k3oni/FOC-75300/production/README.md

# Assembly Guide



Wauw, it looks cool, but unfortunately something has gone wrong in this assembly.

What we want to build here will look something like this:



> (This is an image of an old version) The 3d printed enclosure you can find in the /production folder as obj files. You don't necessarily need an enclosure, but it will protect the components from short circuits etc.

For a complete assembly of Free Drive you will need:



Pcs | Part | LCSC order no.
| ----- | ----- | ----- |
1 | Pre-assembled pcb
85 | Machine header pins (1 lot of 5pcs 2.54mm Pitch 1x40) | [AliExpress](https://www.aliexpress.com/item/1005005053790061.html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)
6 or 12 | Mosfets of type CRST030N10N | C841369
2 | 680uF Aluminum Electrolytic Capacitors D18xL35.5mm | C699524
3 | Female banana bullet connectors | C99865
1 | XT90H-M Male battery connector | C3040683
1 | JST	1x2P 2 pin JST (p=2.0mm) | C7465567
1 | JST 1x6P 6 pin JST (p=2.0mm) | C7465571
x | Cables

Additionally, you might need:
Pcs | Part | LCSC order no.
| ----- | ----- | ----- |
6 or 12 | Mica Insulation Sheet | Aliexpress
6 or 12 | White Insulation Washer TO-220 | Aliexpress
6 or 12 | M3 Stainless Steel Allen Bolts and Screws | Aliexpress
x | Aluminum for sinking heat
x | 3D printed enclosure (production folder)

> The board is produced by the manufacturer as a single pcb. JLCPCB will charge you for the number of designs on a pcb, but this is a single design where the modules are going to be assembled to a single unit. The separation is just for convenience purposes and none of the modules will work on their own.

The 3 modules are connected by taps, and you separate these using a suitable manual saw. Be careful not to damage the traces on the FREE/PILL and POWER modules in particular, as the traces here are close to the edges.

<div>



</div>

You should straighten the edges of the separated modules with sandpaper or a file.

## How to avoid creating solder bridges and other errors by testing throughout the Assembly Procedure
> Any error that you accidentally introduce to the board is really not a big deal, as long as you catch the error early on. This is why it is very important to verify the hardware after each step in the assembly.

Test or you will regret that you didn't!
| -------- |

## Step 1: Uploading Firmware and testing FREE/PILL

FREEPILL can be powered from USB +5V by temporarily bridging the two pads next to the USB-C connector.

<div>



</div>

Now, Connect the FreePill via a USB-C cable to your computer.
In this example I use a STM32F4 Discovery board for uploading firmware, but there are other options available:

[Existing VESC hardware](https://www.youtube.com/watch?v=PFFiVxFHDM4&t=312s)

[stm32f4 Discovery](https://geekilyinteresting.wordpress.com/2014/05/04/using-your-stm32f4-discovery-board-as-a-programmer-and-debugger/)

[ST-LINK windows](https://www.youtube.com/watch?v=etglJKNJSCY)

[stlink-gui on Ubuntu Linux](https://www.youtube.com/watch?v=VhLIKFwoGjo)

<div>


</div>

> There is no specific need for soldering pin-headers to the SWD terminals. Usually you only need a connection for a few seconds, and just applying a bit of tension to the terminals during the upload is enough. The pill is going to be soldered to the bottom side of the main module, and permanent pin-headers are not convenient on this side of the board.
>> The square pad on the pill SWD header is VCC (+3.3V).
>> 
>> In this example I use "stlink-gui" on Linux for uploading firmware. If you're on Widows or Mac use one of the other options.

Flash the bootloader to address 0x08000000. Bootloader can be found in the "binaries" folder.



Next, flash the Vesc firmware, also to address 0x08000000. Can also be found in the "binaries" folder.



Once you have flashed the firmware and the FreePill is booted, the LEDs on the board will show a constant green light and a blinking red light. You should be able to discover the board in the Vesc Tool under the name "FREE_DRIVE".

<div>


</div>

**REMEMBER** to remove the solder bridge again. The assembled FreeDrive will **NOT** work properly if powered by USB.
| ------- |
<div>

</div>

## Step 2: Verify the POWER hardware

Connect the Power Module to a power supply as shown on the image below. Be VERY careful not to short the connections. Set the voltage to +16V with a **current limit of 0.1 Amps**.

<div>


</div>

The module is working properly when the LED on the module shows a constant blue light.

## Step 3: Solder FreePill and Main Module together

Some JST connectors will overlap with the Pill at the terminals marked with red:

<div>

</div>

This is a challenge, because we are going to solder the FreePill and Main Module together using standard pin headers. Because terminals are shared with JST connectors, we remove the pins of the JST sockets where there is overlap, and then the pin-header pins with replace these.

To end up with a proper JST-pin length, we need to pull out the pin-header pins around 1.5 mm at these spots.

<div>




</div>

Follow this procedure in this order:

1. With a set of pliers, on the standard pin headers, pull out the "shared" pins around 1.5 mm with reference to the black plastic spacer.
2. Solder pin headers to the FreePill.
3. (Note: If you want to be able to desolder the two modules later, it's an advantage to remove the plastic spacers on the standard pin headers. By doing so, it's easier to apply heat to the pins so you can pull them out again)
4. Mount the FreePill on the back side of the 'Main Module'.
5. On the front side of the Main Module, solder the FreePill pins to the Main Module. Where you see cutouts for JST connectors, be VERY careful to apply only the slightest amount of solder, or else you will be in trouble when mounting the "plastic only" part of these JSTs later. The GND and +3V terminals will need a lot of heat. If too much solder is applied, you can scrape it off gently using a hobby knife.
6. Pull out JST pins of the JST sockets in those locations where they overlap with the pin-headers that you've already soldered.
7. Carefully, mount these sockets in their respective places on top of the respective pins (pin headers).



## Step 4: Solder power connector pins

Solder 5 power connector pins onto the Main Module.

<div>


</div>

You can now temporarily attact the Power Module to the Main Module. You can bend the pins slightly in order to secure a good connection. Do not solder the two modules together yet (until you have attached heat sinks to mosfets). You should be able to power the complete board by applying +16V across the main supply terminals. **Use a current limit of 0.1A**.

<div>


</div>

At this stage, the board should draw around 0.05A at 16V.

## Step 5: Apply solder to exposed copper planes

Apply around 0.3 mm of solder to the large exposed copper planes of both sides of the Main Module (however, not anything yet to the "phase" planes in between the mosfets).



> Putting a layer of solder on the planes is done for thermal management reasons rather than for enhancing electrical conductivity.
> Solder has better thermal conductivity than the bare copper, so adding a thin layer of solder can enhance the thermal performance further. This can help in better heat dissipation from the switching mosfets, which generate significant heat during operation.

## Step 6: Solder first 6 mosfets



Bending the caps at the right spot is an advantage, if you want to use the screw holes for mounting the heat sink.

> The screw holes for attachment of heat sink doesn't need to align up perfectly, but should not be too much off.



> You choose if you want to attach the remaining 6 mosfets. This obviously depends on the wattage spec you want of the board.

Power up the complete board by applying +16V across the main supply terminals. **Use a current limit of 0.1A**.



The board should obviously draw less than 0.1A - probably around 0.05A.

## Step 7: Solder the wires for main supply positive and negative. Also solder wires for all three phases



Attach a bldc motor to the three phase wires.

Again, apply the same test as in "Step 6"

## Step 8: Test the FREEDRIVE when connected to a BLDC motor

If you were successful so far, connect all three phase wires of a BLDC motor to the FREEDRIVE.

Increase the voltage to +24V and **set a current limit of 0.3A**.

Connect to "FREE_DRIVE" in the Vesc Tool and go to the "Vesc Dev Tools" menu and type the command "help". This should give you a long list of available developer command line options.



Scroll up til you find the "single_bridge_duty" command (a very helpful command currently only available for the FreeDrive firmware).
Write the command:

```
single_bridge_duty 0 0.04 10
```

(which is equivalent to: Apply 4% duty cycle to phase no. 1 (index zero) for 10 seconds)

> If the drive completely shuts down now, or starts blinking. Did you remember to turn up the current to around 0.3A (possibly more for very large motors)?

If you try to turn the motor by hand now, you should feel some mechanical resistance. Note down the draw of current during this 10 second period.

If you run the same command for the two other phases, the draw of current should be around the same value. Also the felt mechanical resistance should be comparable. The commands for the two other phases are:

```
single_bridge_duty 1 0.04 10
```
```
single_bridge_duty 2 0.04 10
```

If something looks or feels odd in this procedure, maybe you accidentally bridged traces during soldering of mosfets?

If you open up the "Sampled Data" menu under "Data Analysis" and click on the "Sample Now" button, you should see something like this:



All phase currents should be centered around zero.

If you lock a single phase for e.g. 20 seconds and do a current measurement during this period, you should see that the current of phase 1 stands out from phase 2 and 3
```
single_bridge_duty 0 0.04 20
```


Phase 2:
```
single_bridge_duty 1 0.04 20
```


Phase 3:
```
single_bridge_duty 2 0.04 20
```


## Step 9: Finish assembly by adding large capacitors or more fets

For better thermal management, apply a layer of solder to the top-side exposed copper planes.



> Don't use the amount of solder applied in this image as a reference. This is too much solder!

When mounting and soldering the 330uF capacitors, remember that the three small pads are positive V_in, and the large exposed copper plane is negative (GND).
<div>




</div>

The FREEDRIVE is now assembled, and you can proceed to the normal procedure of "motor detection" in the VESC Tool.

If you want to 3D print an enclosure for your drive, you can find the .obj-files in the /production folder.
