k3oni/FOC-75300/source/driver.kicad_sch

## KiCad design source/driver.kicad_sch (2024-07-31)

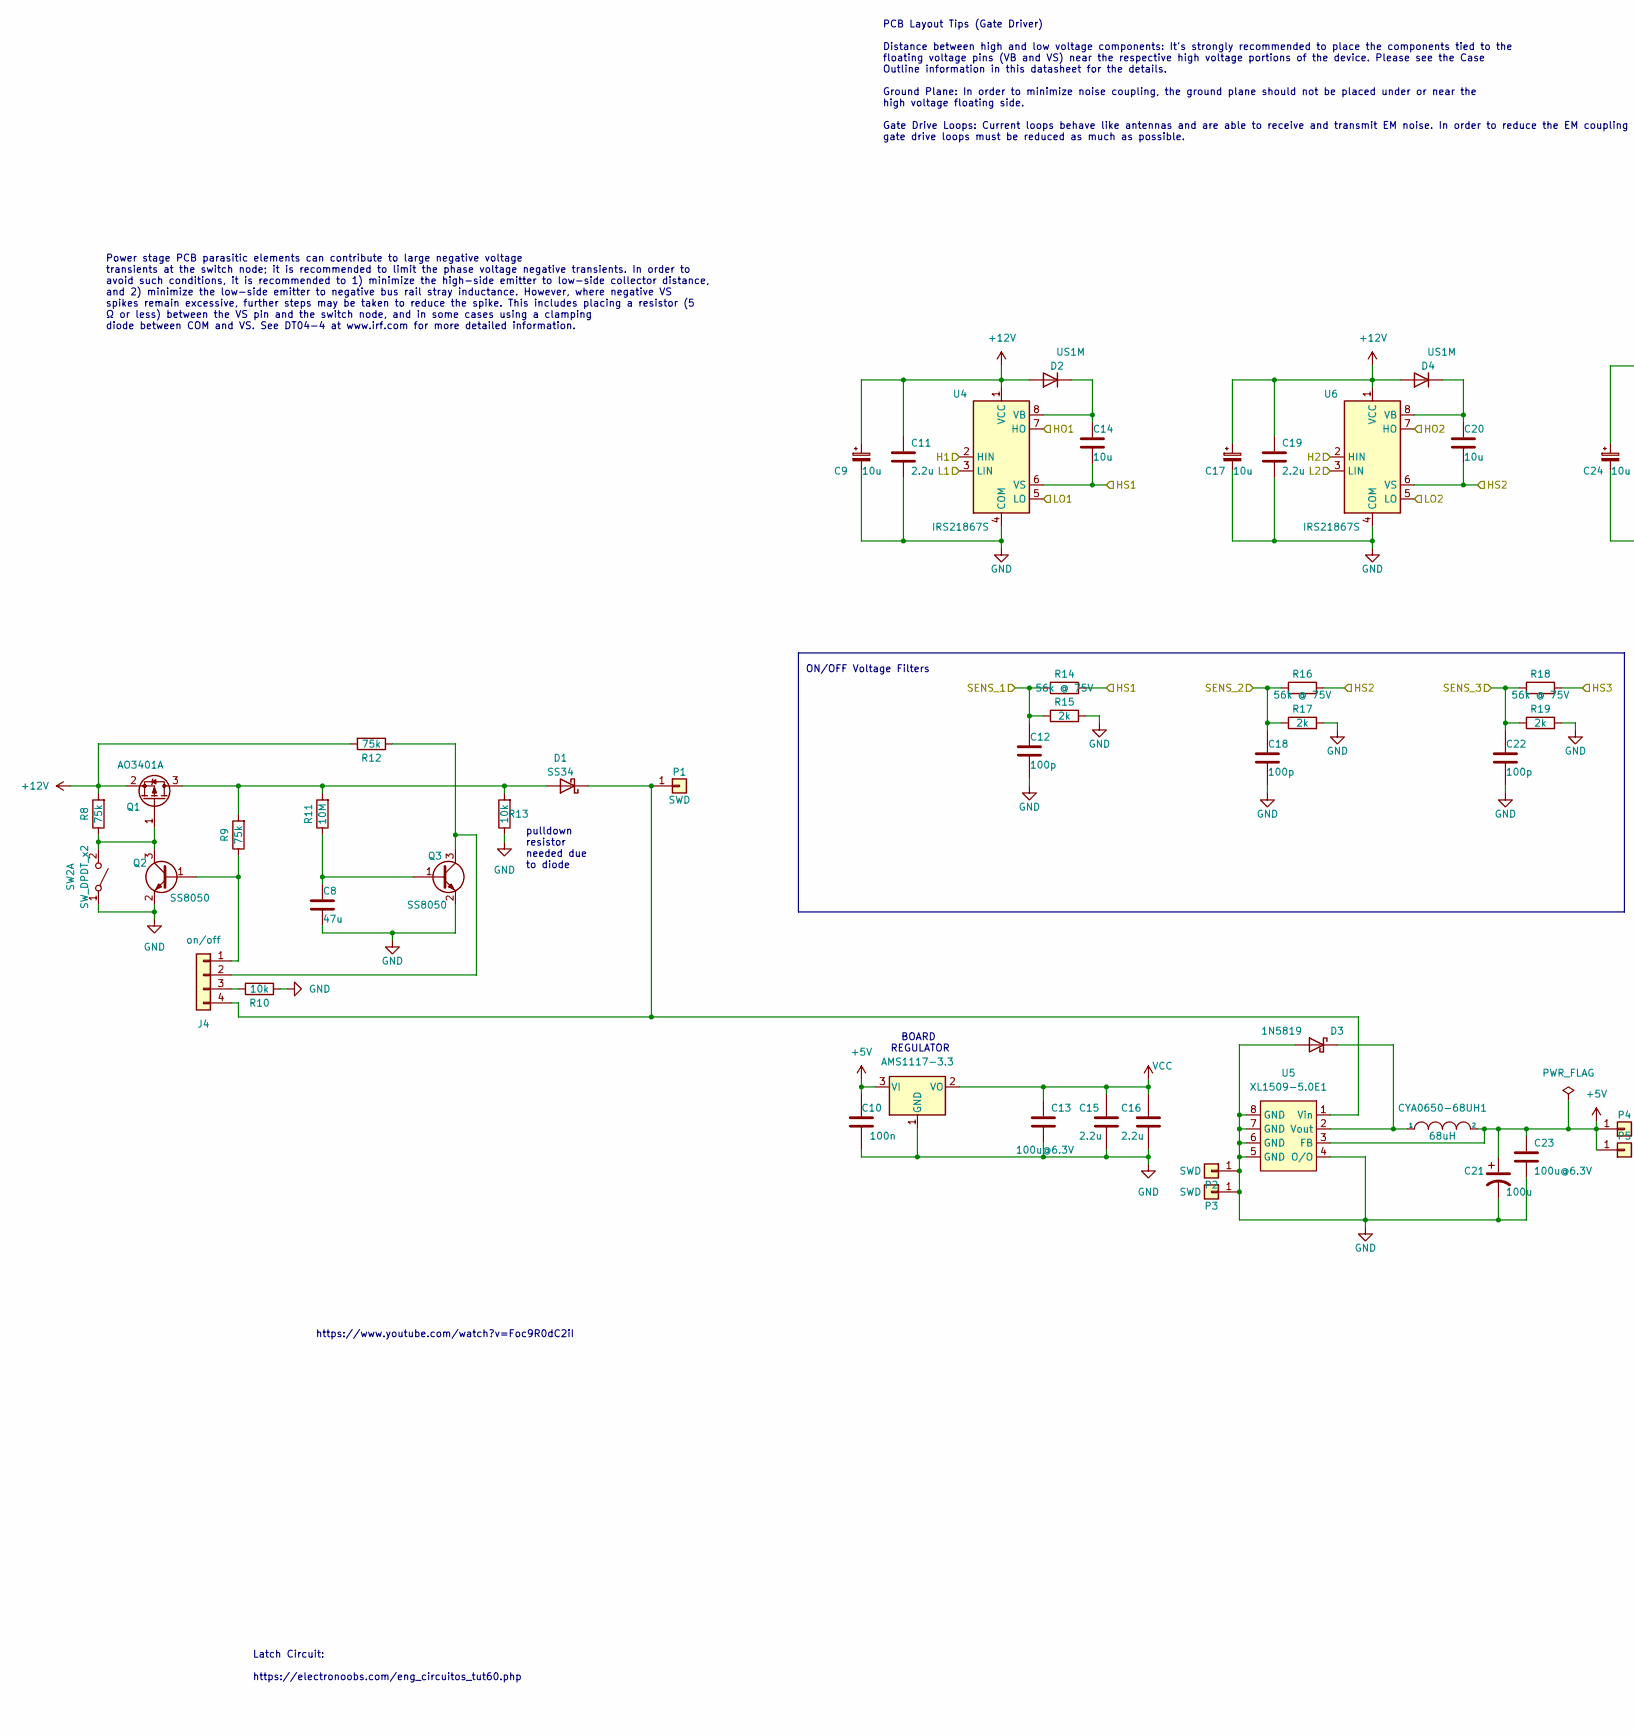
[picture p1: schematic driver.kicad_sch, part in row 1, column 1]

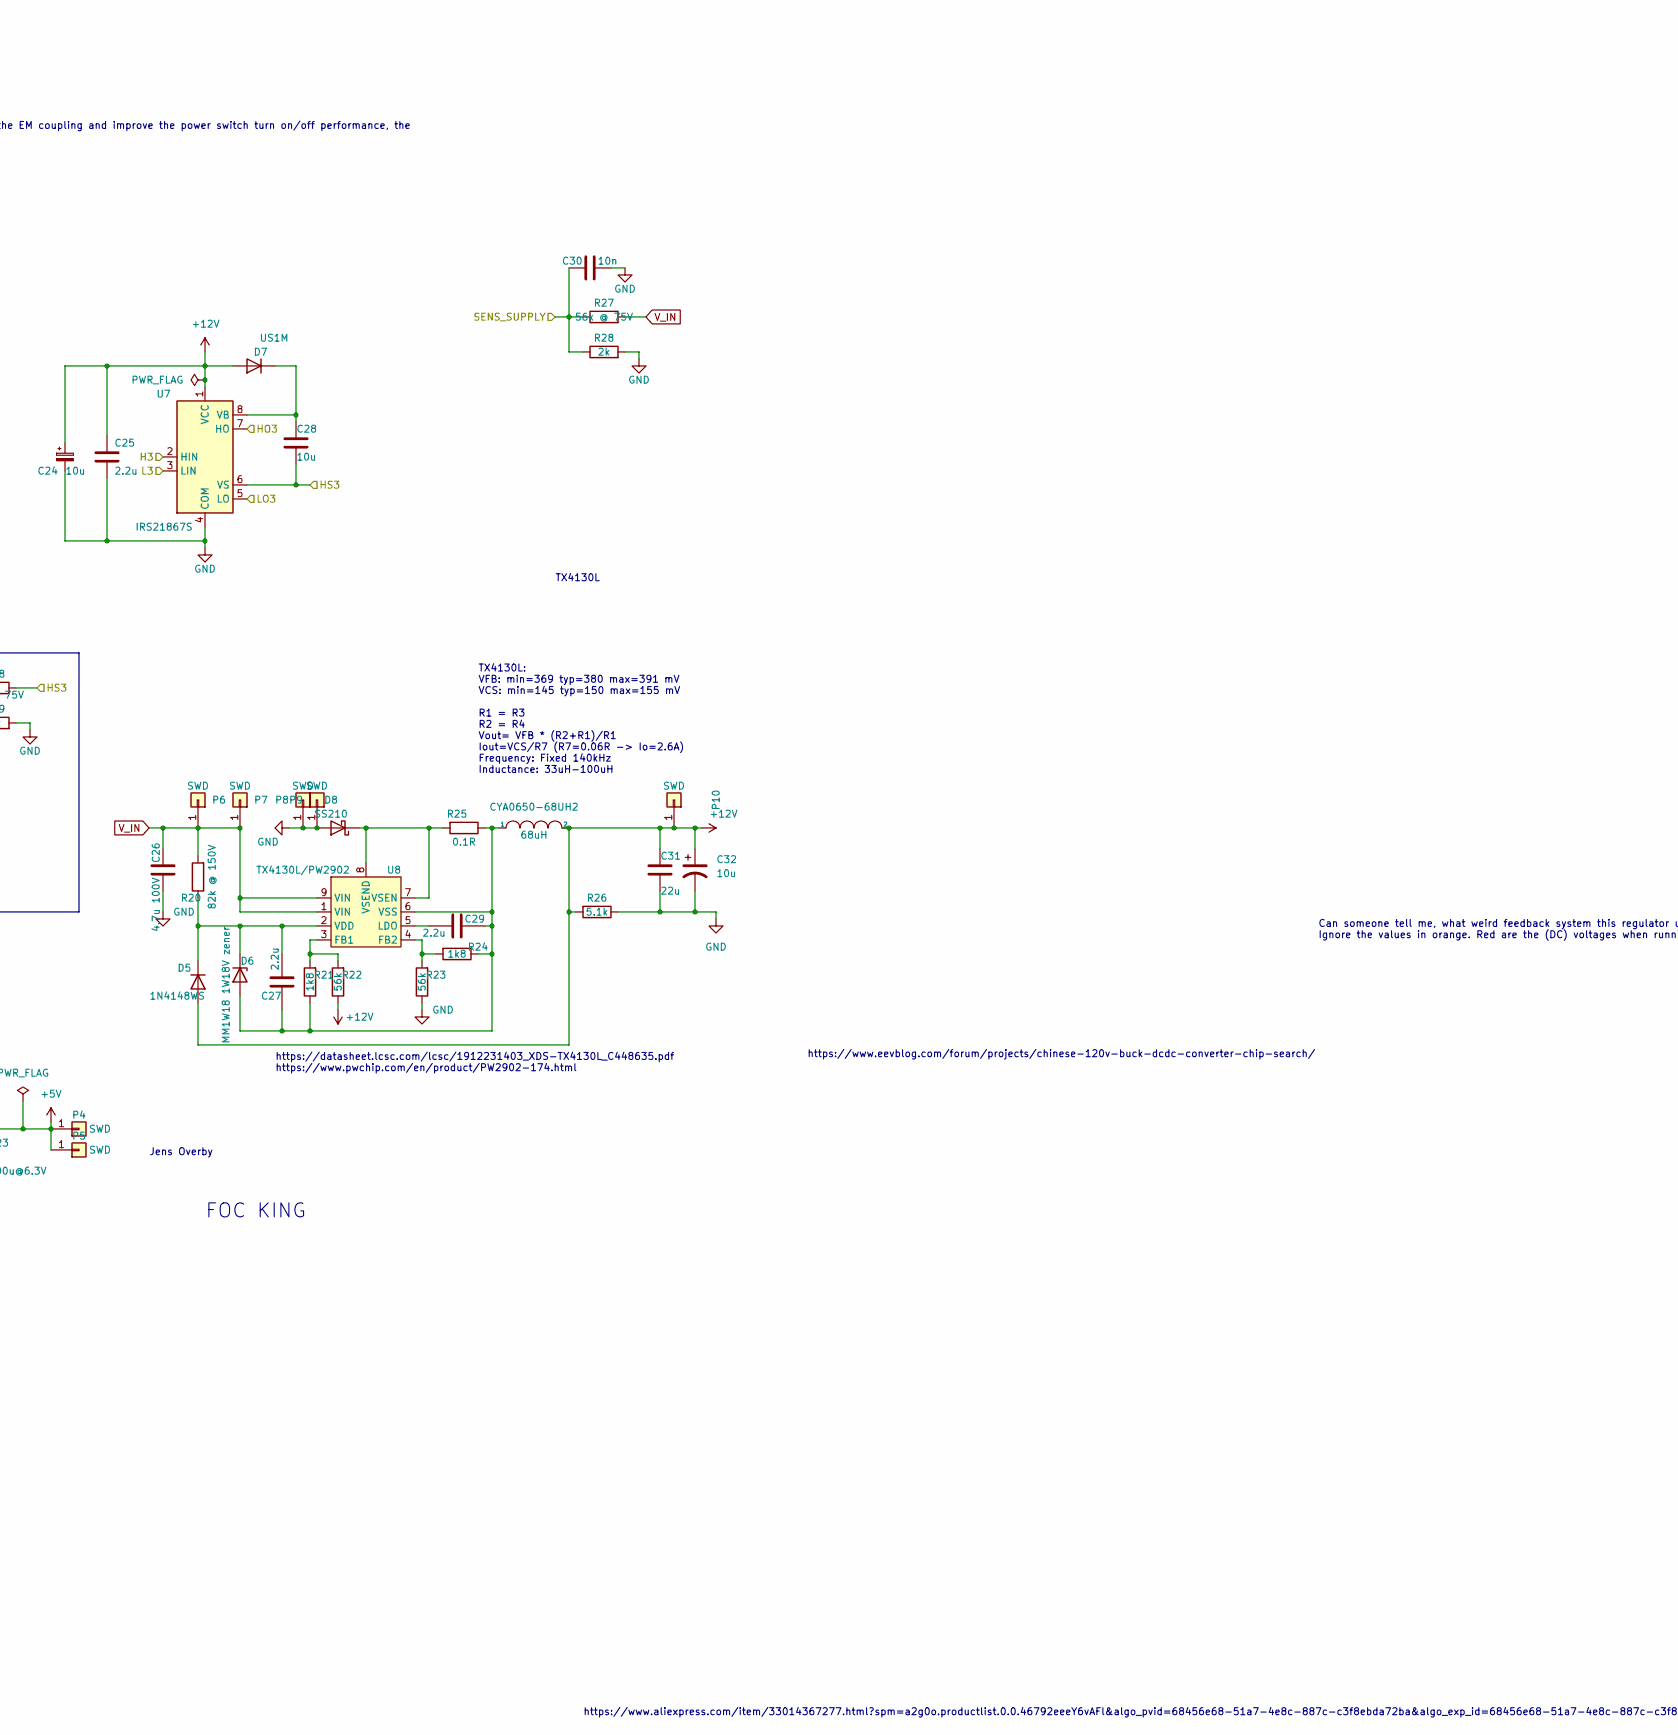
[picture p2: schematic driver.kicad_sch, part in row 1, column 2]

Parts:
C8: 47u; C_0805_2012Metric; LCSC C16780
C9, C17, C24, C32: 10u; CP_EIA-3216-10_Kemet-I; LCSC C7171
C10: 100n; C_0603_1608Metric; LCSC C14663
C11, C15, C16, C19, C25, C27, C29: 2.2u; C_0603_1608Metric; LCSC C23630
C12, C18, C22: 100p; C_0603_1608Metric; LCSC C14858
C13, C23: 100u@6.3V; C_1206_3216Metric; LCSC C15008
C14, C20, C28: 10u; C_0603_1608Metric; LCSC C96446
C21: 100u; CP_EIA-3528-21_Kemet-B; LCSC C16133
C26: 4.7u 100V; C_1210_3225Metric; LCSC C381466
C30: 10n; C_0603_1608Metric; LCSC C57112
C31: 22u; C_0805_2012Metric; LCSC C45783
CYA0650-68UH1, CYA0650-68UH2: 68uH; L_6.6x7.2_H5.0_CYA0650_68UH; LCSC C5189964
D1: SS34; D_SMA; LCSC C8678
D2, D4, D7: US1M; D_SOD-123; LCSC C412437
D3: 1N5819; D_DO-41_SOD81_P10.16mm_Horizontal; LCSC C191023
D5: 1N4148WS; D_SOD-123; LCSC C2128
D6: MM1W18 1W18V zener; D_SOD-123; LCSC C382948
D8: SS210; D_SMA; LCSC C14996
J4: on/off; JST_PH_B4B-PH-K_1x04_P2.00mm_Vertical
P1, P2, P3, P4, P5, P6, P7, P8, P9, P10: SWD; PinHeader_1x01_P2.54mm_Vertical
Q1: AO3401A; SOT-23; LCSC C15127
Q2, Q3: SS8050; SOT-23; LCSC C2150
R8, R9, R12: 75k; R_0603_1608Metric; LCSC C23242
R10, R13: 10k; R_0603_1608Metric; LCSC C25804
R11: 10M; R_0603_1608Metric; LCSC C7250
R14, R16, R18, R27: 56k @ 75V; R_0603_1608Metric; LCSC C23206
R15, R17, R19, R28: 2k; R_0603_1608Metric; LCSC C22975
R20: 82k @ 150V; R_0805_2012Metric; LCSC C17840
R21, R24: 1k8; R_0603_1608Metric; LCSC C4177
R22, R23: 56k; R_0603_1608Metric; LCSC C23206
R25: 0.1R; R_1206_3216Metric; LCSC C25334
R26: 5.1k; R_0603_1608Metric; LCSC C23186
SW2: SW_DPDT_x2; SolderJumper-2_P1.3mm_Open_Pad1.0x1.5mm
U3: AMS1117-3.3; SOT-223-3_TabPin2; LCSC C6186
U4, U6, U7: IRS21867S; SOIC-8_3.9x4.9mm_P1.27mm; LCSC C52290
U5: XL1509-5.0E1; SOP-8_3.9x4.9mm_P1.27mm; LCSC C61063
U8: TX4130L/PW2902; TX4130L_ESOP-8; LCSC C448635

Connections:
+5V: C10.2, C21.1, C23.1, CYA0650-68UH1.2, P4.1, P5.1, U3.3 (VI), U5.3 (FB)
+12V: C9.1, C11.1, C17.1, C19.1, C24.1, C25.1, C31.1, C32.1, CYA0650-68UH2.2, D2.2 (A), D4.2 (A), D5.2 (A), D7.2 (A), P10.1, Q1.2 (S), R8.2, R12.2, R22.1, R26.2, U4.1 (VCC), U6.1 (VCC), U7.1 (VCC)
GND: C8.2, C9.2, C10.1, C11.2, C12.1, C13.2, C15.2, C16.2, C17.2, C18.1, C19.2, C21.2, C22.1, C23.2, C24.2, C25.2, C26.1, C30.2, C31.2, C32.2, D3.2 (A), D8.2 (A), P2.1, P3.1, P8.1, P9.1, Q2.2 (E), Q3.2 (E), R10.2, R13.1, R15.2, R17.2, R19.2, R23.1, R26.1, R28.2, SW2.1 (A), U3.1 (GND), U4.4 (COM), U5.4 (O/O), U5.5 (GND), U5.6 (GND), U5.7 (GND), U5.8 (GND), U6.4 (COM), U7.4 (COM)
H1: U4.2 (HIN)
H2: U6.2 (HIN)
H3: U7.2 (HIN)
HO1: U4.7 (HO)
HO2: U6.7 (HO)
HO3: U7.7 (HO)
HS1: C14.2, R14.2, U4.6 (VS)
HS2: C20.2, R16.2, U6.6 (VS)
HS3: C28.2, R18.2, U7.6 (VS)
L1: U4.3 (LIN)
L2: U6.3 (LIN)
L3: U7.3 (LIN)
LO1: U4.5 (LO)
LO2: U6.5 (LO)
LO3: U7.5 (LO)
unnamed: C8.1, Q3.1 (B), R11.1
unnamed: C14.1, D2.1 (K), U4.8 (VB)
unnamed: C20.1, D4.1 (K), U6.8 (VB)
unnamed: C27.1, C29.1, CYA0650-68UH2.1, D6.2 (A), R21.1, R24.1, R25.1, U8.6 (VSS)
unnamed: C27.2, D5.1 (K), D6.1 (K), R20.1, U8.2 (VDD)
unnamed: C28.1, D7.1 (K), U7.8 (VB)
unnamed: C29.2, U8.5 (LDO)
unnamed: CYA0650-68UH1.1, D3.1 (K), U5.2 (Vout)
unnamed: D1.1 (K), J4.4, P1.1, U5.1 (Vin)
unnamed: D1.2 (A), Q1.3 (D), R9.2, R11.2, R13.2
unnamed: D8.1 (K), R25.2, U8.7 (VSEN), U8.8 (VSEND)
unnamed: J4.1, Q2.1 (B), R9.1
unnamed: J4.2, Q3.3 (C), R12.1
unnamed: J4.3, R10.1
unnamed: Q1.1 (G), Q2.3 (C), R8.1, SW2.2 (B)
unnamed: R21.2, R22.2, U8.3 (FB1)
unnamed: R23.2, R24.2, U8.4 (FB2)
SENS_1: C12.2, R14.1, R15.1
SENS_2: C18.2, R16.1, R17.1
SENS_3: C22.2, R18.1, R19.1
SENS_SUPPLY: C30.1, R27.1, R28.1
VCC: C13.1, C15.1, C16.1, U3.2 (VO)
V_IN: C26.2, P6.1, P7.1, R20.2, R27.2, U8.1 (VIN), U8.9 (VIN)

Notes on the sheet:
PCB Layout Tips (Gate Driver) Distance between high and low voltage components: It's strongly recommended to place the components tied to the floating voltage pins (VB and VS) near the respective high voltage portions of the device. Please see the Case Outline information in this datasheet for the 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
BOARD REGULATOR
ON/OFF Voltage Filters
TX4130L: VFB: min=369 typ=380 max=391 mV VCS: min=145 typ=150 max=155 mV R1 = R3 R2 = R4 Vout= VFB * (R2+R1)/R1 Iout=VCS/R7 (R7=0.06R -> Io=2.6A) Frequency: Fixed 140kHz Inductance: 33uH-100uH
Latch Circuit: https://electronoobs.com/eng_circuitos_tut60.php
Can someone tell me, what weird feedback system this regulator uses? Attached a schematic, that is used for around 5V. Ignore the values in orange. Red are the (DC) voltages when running.
https://www.eevblog.com/forum/projects/chinese-120v-buck-dcdc-converter-chip-search/
https://www.youtube.com/watch?v=Foc9R0dC2iI
TX4130L
FOC KING
pulldown resistor needed due to diode
https://www.aliexpress.com/item/33014367277.html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…
https://datasheet.lcsc.com/lcsc/1912231403_XDS-TX4130L_C448635.pdf https://www.pwchip.com/en/product/PW2902-174.html
Power stage PCB parasitic elements can contribute to large negative voltage transients at the switch node; it is recommended to limit the phase voltage negative transients. In order to avoid such conditions, it is recommended to 1) minimize the high-side emitter to low-side collector distance, and 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
Jens Overby
