k3oni/FOC-75300/source/foc.kicad_sch

## KiCad design source/foc.kicad_sch (2024-07-31)

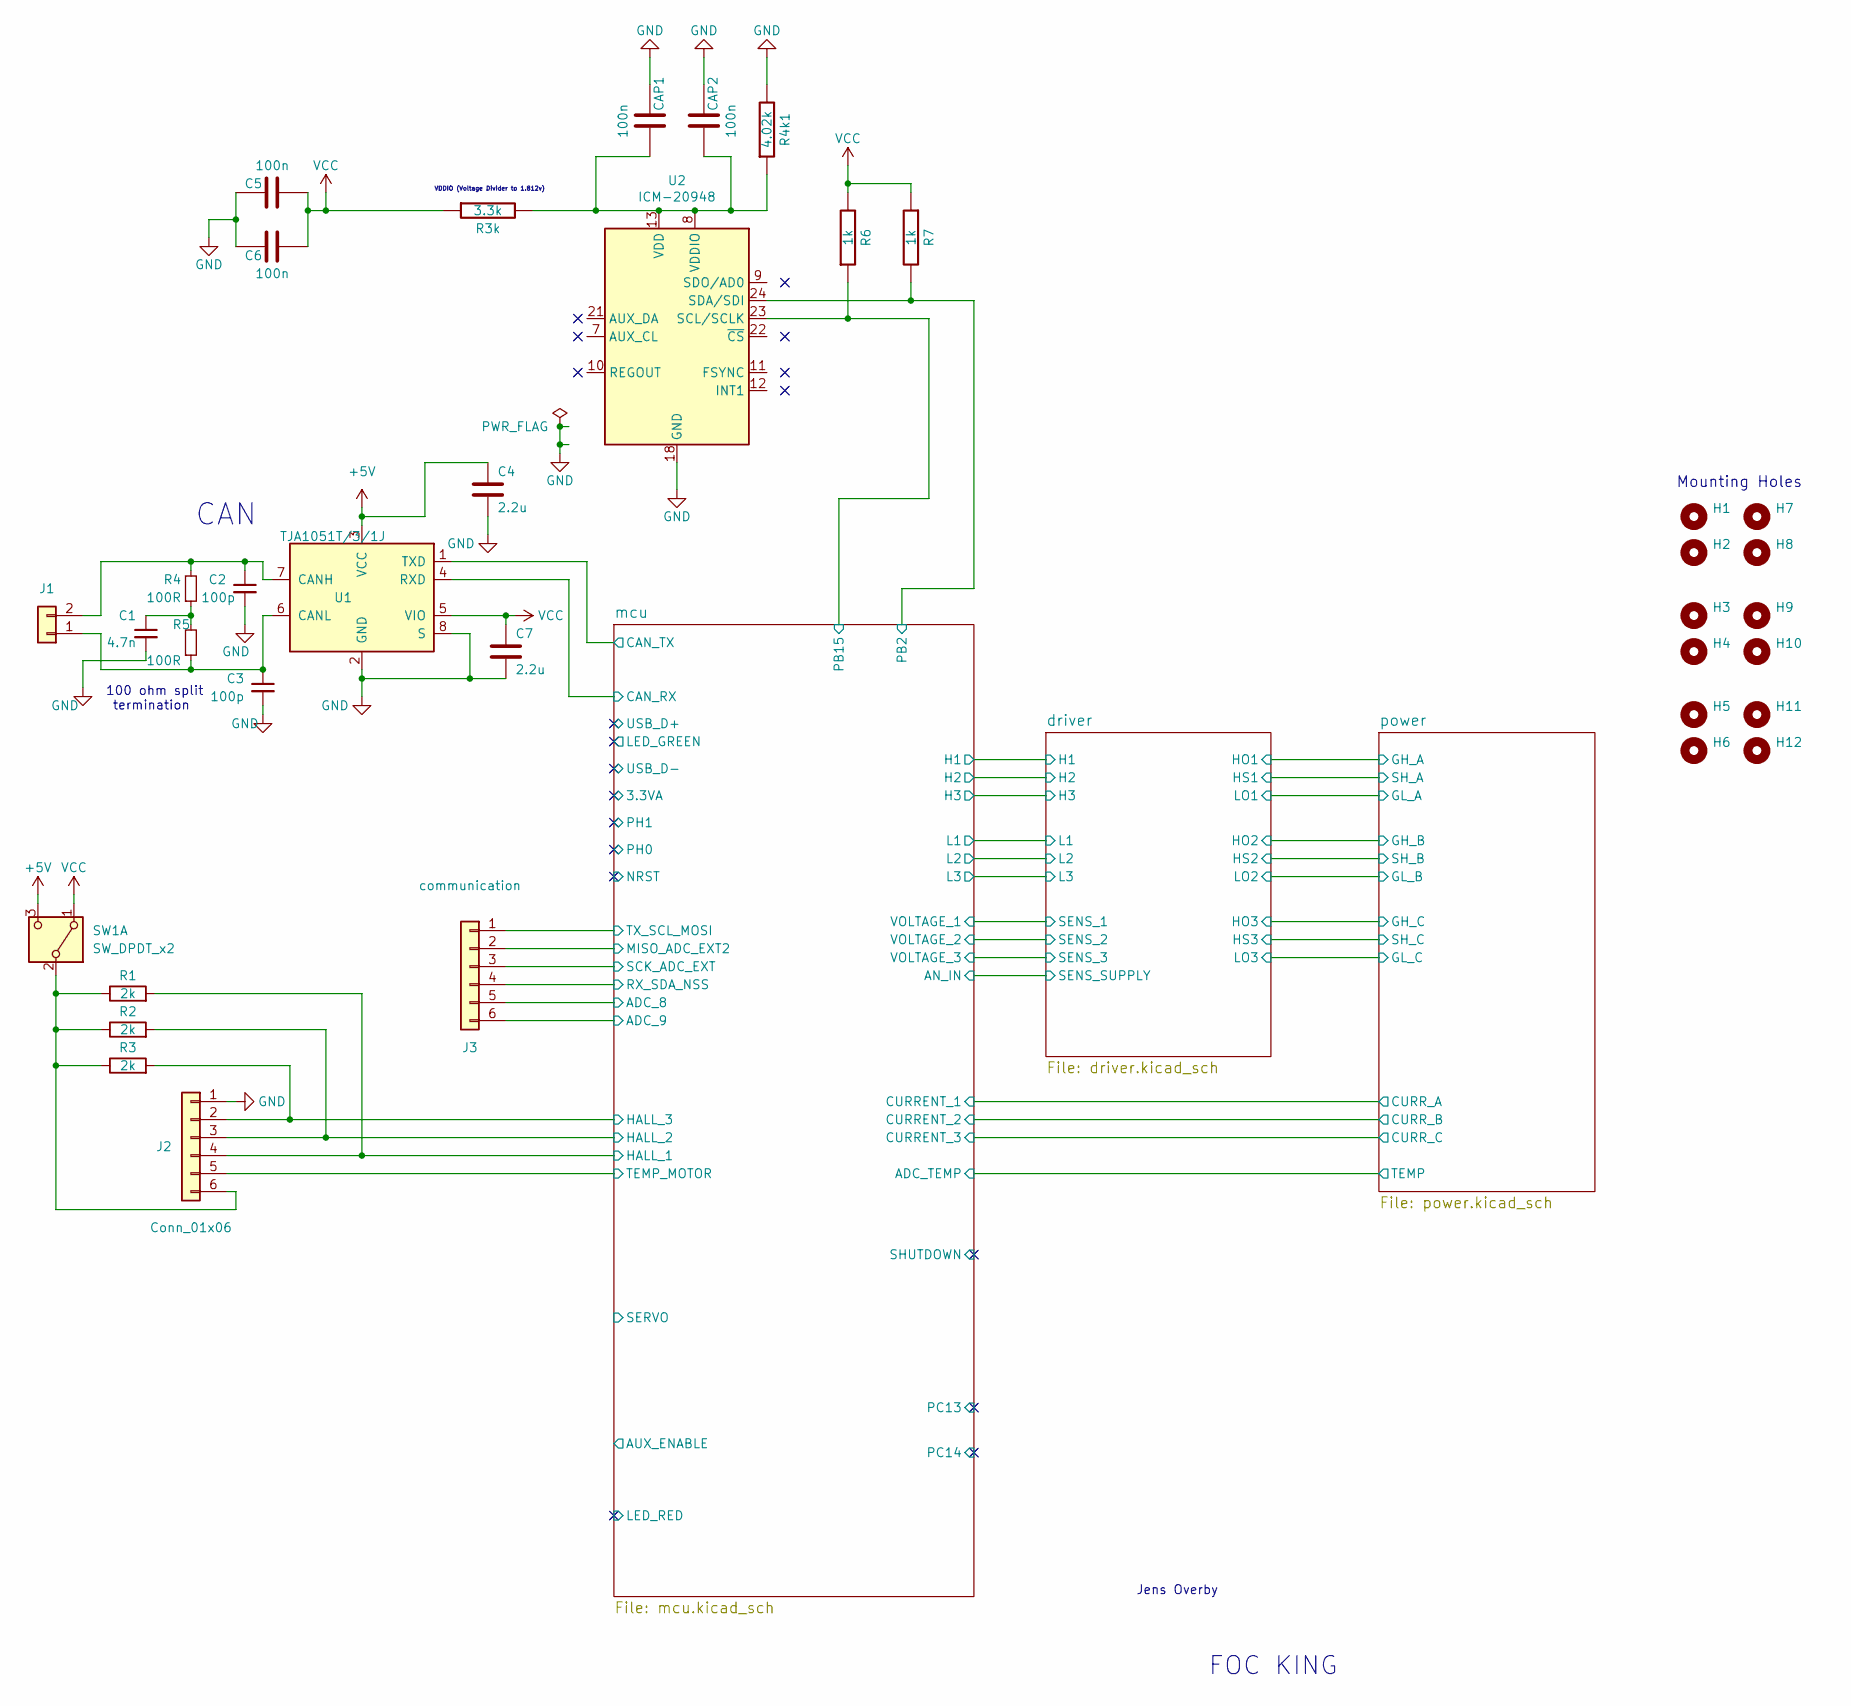
[picture p3: schematic foc.kicad_sch]

Parts:
C1: 4.7n; C_0603_1608Metric; LCSC C53987
C2, C3: 100p; C_0603_1608Metric; LCSC C14858
C4, C7: 2.2u; C_0603_1608Metric; LCSC C23630
C5, C6: 100n; C_0603_1608Metric; LCSC C14663
CAP1, CAP2: 100n; C_0603_1608Metric; LCSC C14663
H1, H2, H3, H4, H5, H6, H7, H8, H9, H10, H11, H12: MountingHole; MountingHole_3.2mm_M3
J1: Conn_01x02_Male; JST_PH_B2B-PH-K_1x02_P2.00mm_Vertical
J2: Conn_01x06; JST_PH_B6B-PH-K_1x06_P2.00mm_Vertical
J3: communication; JST_XH_B6B-XH-A_1x06_P2.50mm_Vertical
R1, R2, R3: 2k; R_0603_1608Metric; LCSC C22975
R3k: 3.3k; R_0603_1608Metric; LCSC C21190
R4, R5: 100R; R_0603_1608Metric; LCSC C22775
R4k1: 4.02k; R_0603_1608Metric; LCSC C21190
R6, R7: 1k; R_0603_1608Metric; LCSC C21190
SW1: SW_DPDT_x2; SolderJumper-3_P1.3mm_Bridged2Bar12_Pad1.0x1.5mm
U1: TJA1051T/3/1J; SOIC-8_3.9x4.9mm_P1.27mm; LCSC C38695
U2: ICM-20948; InvenSense_QFN-24_3x3mm_P0.4mm; LCSC C94021

Connections:
+5V: C4.1, SW1.3 (C), U1.3 (VCC)
ADC_8: J3.5
ADC_9: J3.6
CAN_RX: U1.4 (RXD)
CAN_TX: U1.1 (TXD)
GND: C1.2, C2.2, C3.2, C4.2, C5.1, C6.1, C7.2, CAP1.1, CAP2.1, J2.1, R4k1.2, U1.2 (GND), U1.8 (S), U2.18 (GND), U2.20 (GND)
HALL_1: J2.4, R1.2
HALL_2: J2.3, R2.2
HALL_3: J2.2, R3.2
MISO_ADC_EXT2: J3.2
unnamed: C1.1, R4.1, R5.2
unnamed: C2.1, J1.2, R4.2, U1.7 (CANH)
unnamed: C3.1, J1.1, R5.1, U1.6 (CANL)
unnamed: CAP1.2, CAP2.2, R3k.2, R4k1.1, U2.8 (VDDIO), U2.13 (VDD)
unnamed: J2.6, R1.1, R2.1, R3.1, SW1.2 (B)
PB2: R7.2, U2.24 (SDA/SDI)
PB15: R6.1, U2.23 (SCL/SCLK)
RX_SDA_NSS: J3.4
SCK_ADC_EXT: J3.3
TEMP_MOTOR: J2.5
TX_SCL_MOSI: J3.1
VCC: C5.2, C6.2, C7.1, R3k.1, R6.2, R7.1, SW1.1 (A), U1.5 (VIO)

Notes on the sheet:
100 ohm split termination
CAN
FOC KING
Mounting Holes
Jens Overby
VDDIO (Voltage Divider to 1.812v)
