k3oni/FOC-75300/source/mcu.kicad_sch

## KiCad design source/mcu.kicad_sch (2024-07-31)

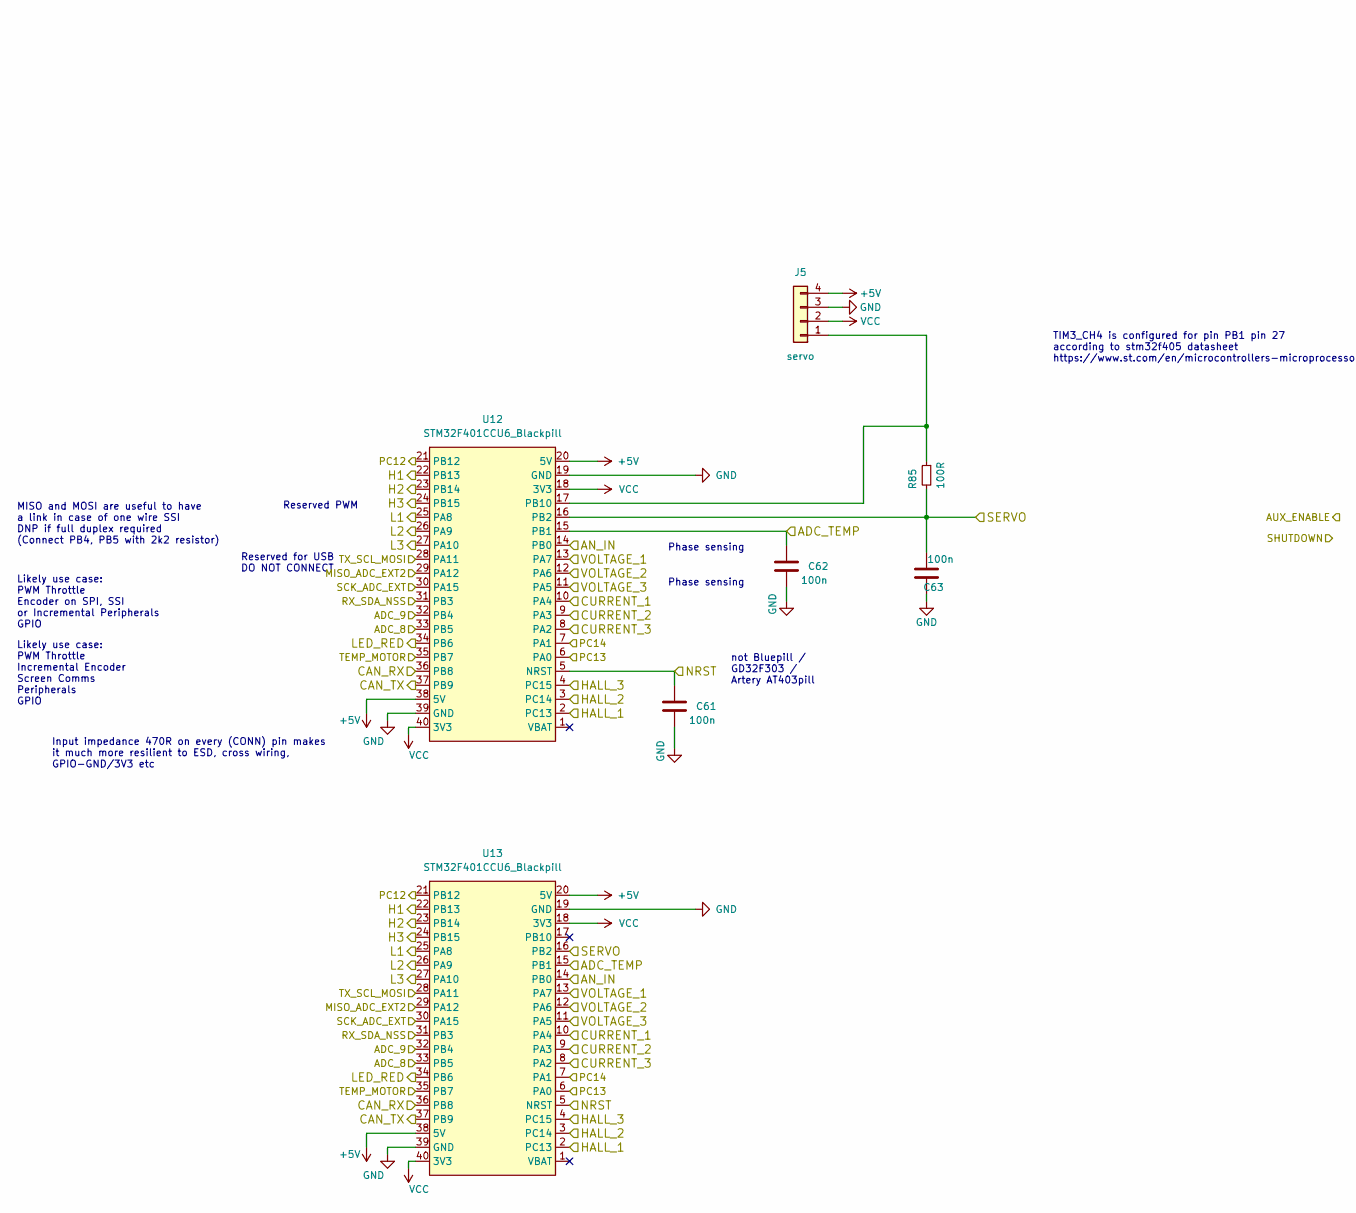
[picture p4: schematic mcu.kicad_sch, part in row 1, column 1]

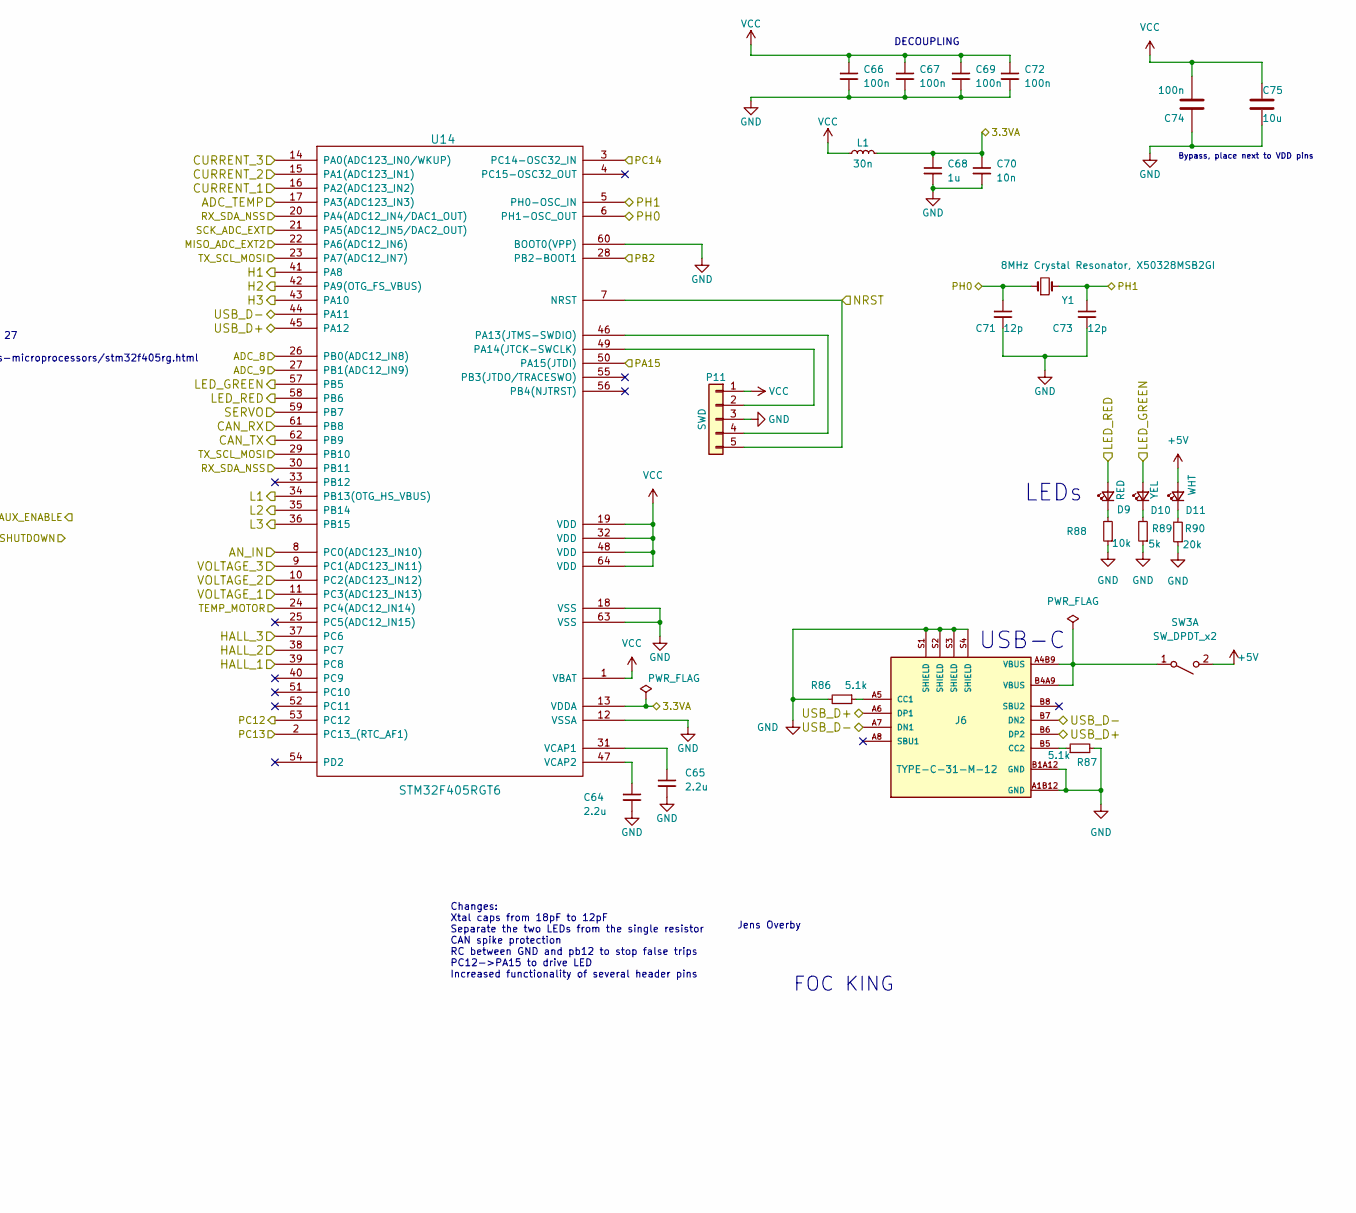
[picture p5: schematic mcu.kicad_sch, part in row 1, column 2]

Parts:
C61, C62, C63, C66, C67, C69, C72, C74: 100n; C_0603_1608Metric; LCSC C14663
C64, C65: 2.2u; C_0603_1608Metric; LCSC C23630
C68: 1u; C_0603_1608Metric; LCSC C15849
C70: 10n; C_0603_1608Metric; LCSC C57112
C71, C73: 12p; C_0603_1608Metric; LCSC C38523
C75: 10u; C_0603_1608Metric; LCSC C96446
D9: RED; LED_0805_2012Metric; LCSC C84256
D10: YEL; LED_0805_2012Metric; LCSC C2296
D11: WHT; LED_0603_1608Metric; LCSC C2290
J5: servo; JST_XH_B4B-XH-A_1x04_P2.50mm_Vertical
J6: TYPE-C-31-M-12; HRO_TYPE-C-31-M-12; PARTREV A; LCSC C165948
L1: 30n; L_0603_1608Metric; LCSC C280269
P11: SWD; PinHeader_1x05_P2.54mm_Vertical
R85: 100R; R_0603_1608Metric; LCSC C22775
R86, R87: 5.1k; R_0603_1608Metric; LCSC C23186
R88: 10k; R_0603_1608Metric; LCSC C25804
R89: 5k; R_0603_1608Metric; LCSC C23046
R90: 20k; R_0603_1608Metric; LCSC C4184
SW3: SW_DPDT_x2; SolderJumper-2_P1.3mm_Open_Pad1.0x1.5mm
U12, U13: STM32F401CCU6_Blackpill; Blackpill_STM32F401CEU6
U14: STM32F405RGT6; LQFP-64_10x10mm_P0.5mm; LCSC C15742
Y1: 8MHz Crystal Resonator, X50328MSB2GI; Crystal_SMD_5032-2Pin_5.0x3.2mm; LCSC C115962

Connections:
3.3VA: C68.1, C70.1, L1.2, U14.13 (VDDA)
+5V: D11.2 (A), J5.4, SW3.2 (B), U12.20 (5V), U12.38 (5V), U13.20 (5V), U13.38 (5V)
ADC_8: U12.33 (PB5), U13.33 (PB5), U14.26 (PB0(ADC12_IN8))
ADC_9: U12.32 (PB4), U13.32 (PB4), U14.27 (PB1(ADC12_IN9))
ADC_TEMP: C62.1, U12.15 (PB1), U13.15 (PB1), U14.17 (PA3(ADC123_IN3))
AN_IN: U12.14 (PB0), U13.14 (PB0), U14.8 (PC0(ADC123_IN10))
CAN_RX: U12.36 (PB8), U13.36 (PB8), U14.61 (PB8)
CAN_TX: U12.37 (PB9), U13.37 (PB9), U14.62 (PB9)
CURRENT_1: U12.10 (PA4), U13.10 (PA4), U14.16 (PA2(ADC123_IN2))
CURRENT_2: U12.9 (PA3), U13.9 (PA3), U14.15 (PA1(ADC123_IN1))
CURRENT_3: U12.8 (PA2), U13.8 (PA2), U14.14 (PA0(ADC123_IN0/WKUP))
GND: C61.2, C62.2, C63.2, C64.2, C65.2, C66.2, C67.2, C68.2, C69.2, C70.2, C71.2, C72.2, C73.2, C74.1, C75.2, J5.3, J6.A1B12 (GND), J6.B1A12 (GND), J6.S1 (SHIELD), J6.S2 (SHIELD), J6.S3 (SHIELD), J6.S4 (SHIELD), P11.3, R86.2, R87.2, R88.1, R89.1, R90.1, U12.19 (GND), U12.39 (GND), U13.19 (GND), U13.39 (GND), U14.12 (VSSA), U14.18 (VSS), U14.60 (BOOT0(VPP)), U14.63 (VSS)
H1: U12.22 (PB13), U13.22 (PB13), U14.41 (PA8)
H2: U12.23 (PB14), U13.23 (PB14), U14.42 (PA9(OTG_FS_VBUS))
H3: U12.24 (PB15), U13.24 (PB15), U14.43 (PA10)
HALL_1: U12.2 (PC13), U13.2 (PC13), U14.39 (PC8)
HALL_2: U12.3 (PC14), U13.3 (PC14), U14.38 (PC7)
HALL_3: U12.4 (PC15), U13.4 (PC15), U14.37 (PC6)
L1: U12.25 (PA8), U13.25 (PA8), U14.34 (PB13(OTG_HS_VBUS))
L2: U12.26 (PA9), U13.26 (PA9), U14.35 (PB14)
L3: U12.27 (PA10), U13.27 (PA10), U14.36 (PB15)
LED_GREEN: D10.2 (A), U14.57 (PB5)
LED_RED: D9.2 (A), U12.34 (PB6), U13.34 (PB6), U14.58 (PB6)
MISO_ADC_EXT2: U12.29 (PA12), U13.29 (PA12), U14.22 (PA6(ADC12_IN6))
NRST: C61.1, P11.5, U12.5 (NRST), U13.5 (NRST), U14.7 (NRST)
unnamed: C64.1, U14.47 (VCAP2)
unnamed: C65.1, U14.31 (VCAP1)
unnamed: D9.1 (K), R88.2
unnamed: D10.1 (K), R89.2
unnamed: D11.1 (K), R90.2
unnamed: J5.1, R85.1, U12.17 (PB10)
unnamed: J6.A4B9 (VBUS), J6.B4A9 (VBUS), SW3.1 (A)
unnamed: J6.A5 (CC1), R86.1
unnamed: J6.B5 (CC2), R87.1
unnamed: P11.2, U14.49 (PA14(JTCK-SWCLK))
unnamed: P11.4, U14.46 (PA13(JTMS-SWDIO))
PA15: U14.50 (PA15(JTDI))
PB2: U14.28 (PB2-BOOT1)
PC12: U12.21 (PB12), U13.21 (PB12), U14.53 (PC12)
PC13: U12.6 (PA0), U13.6 (PA0), U14.2 (PC13_(RTC_AF1))
PC14: U12.7 (PA1), U13.7 (PA1), U14.3 (PC14-OSC32_IN)
PH0: C71.1, U14.6 (PH1-OSC_OUT), Y1.1
PH1: C73.1, U14.5 (PH0-OSC_IN), Y1.2
RX_SDA_NSS: U12.31 (PB3), U13.31 (PB3), U14.20 (PA4(ADC12_IN4/DAC1_OUT)), U14.30 (PB11)
SCK_ADC_EXT: U12.30 (PA15), U13.30 (PA15), U14.21 (PA5(ADC12_IN5/DAC2_OUT))
SERVO: C63.1, R85.2, U12.16 (PB2), U13.16 (PB2), U14.59 (PB7)
TEMP_MOTOR: U12.35 (PB7), U13.35 (PB7), U14.24 (PC4(ADC12_IN14))
TX_SCL_MOSI: U12.28 (PA11), U13.28 (PA11), U14.23 (PA7(ADC12_IN7)), U14.29 (PB10)
USB_D+: J6.A6 (DP1), J6.B6 (DP2), U14.45 (PA12)
USB_D-: J6.A7 (DN1), J6.B7 (DN2), U14.44 (PA11)
VCC: C66.1, C67.1, C69.1, C72.1, C74.2, C75.1, J5.2, L1.1, P11.1, U12.18 (3V3), U12.40 (3V3), U13.18 (3V3), U13.40 (3V3), U14.1 (VBAT), U14.19 (VDD), U14.32 (VDD), U14.48 (VDD), U14.64 (VDD)
VOLTAGE_1: U12.13 (PA7), U13.13 (PA7), U14.11 (PC3(ADC123_IN13))
VOLTAGE_2: U12.12 (PA6), U13.12 (PA6), U14.10 (PC2(ADC123_IN12))
VOLTAGE_3: U12.11 (PA5), U13.11 (PA5), U14.9 (PC1(ADC123_IN11))

Notes on the sheet:
Input impedance 470R on every (CONN) pin makes it much more resilient to ESD, cross wiring, GPIO-GND/3V3 etc
Phase sensing
TIM3_CH4 is configured for pin PB1 pin 27 according to stm32f405 datasheet https://www.st.com/en/microcontrollers-microprocessors/stm32f405rg.html
DECOUPLING
Changes: Xtal caps from 18pF to 12pF Separate the two LEDs from the single resistor CAN spike protection RC between GND and pb12 to stop false trips PC12->PA15 to drive LED Increased functionality of several header pins
LEDs
Jens Overby
not Bluepill / GD32F303 / Artery AT403pill
Likely use case: PWM Throttle Encoder on SPI, SSI or Incremental Peripherals GPIO
MISO and MOSI are useful to have a link in case of one wire SSI DNP if full duplex required (Connect PB4, PB5 with 2k2 resistor)
Reserved PWM
Likely use case: PWM Throttle Incremental Encoder Screen Comms Peripherals GPIO
Reserved for USB DO NOT CONNECT
FOC KING
USB-C
Bypass, place next to VDD pins
