k3oni/FOC-75300/source/power.kicad_sch

## KiCad design source/power.kicad_sch (2024-07-31)

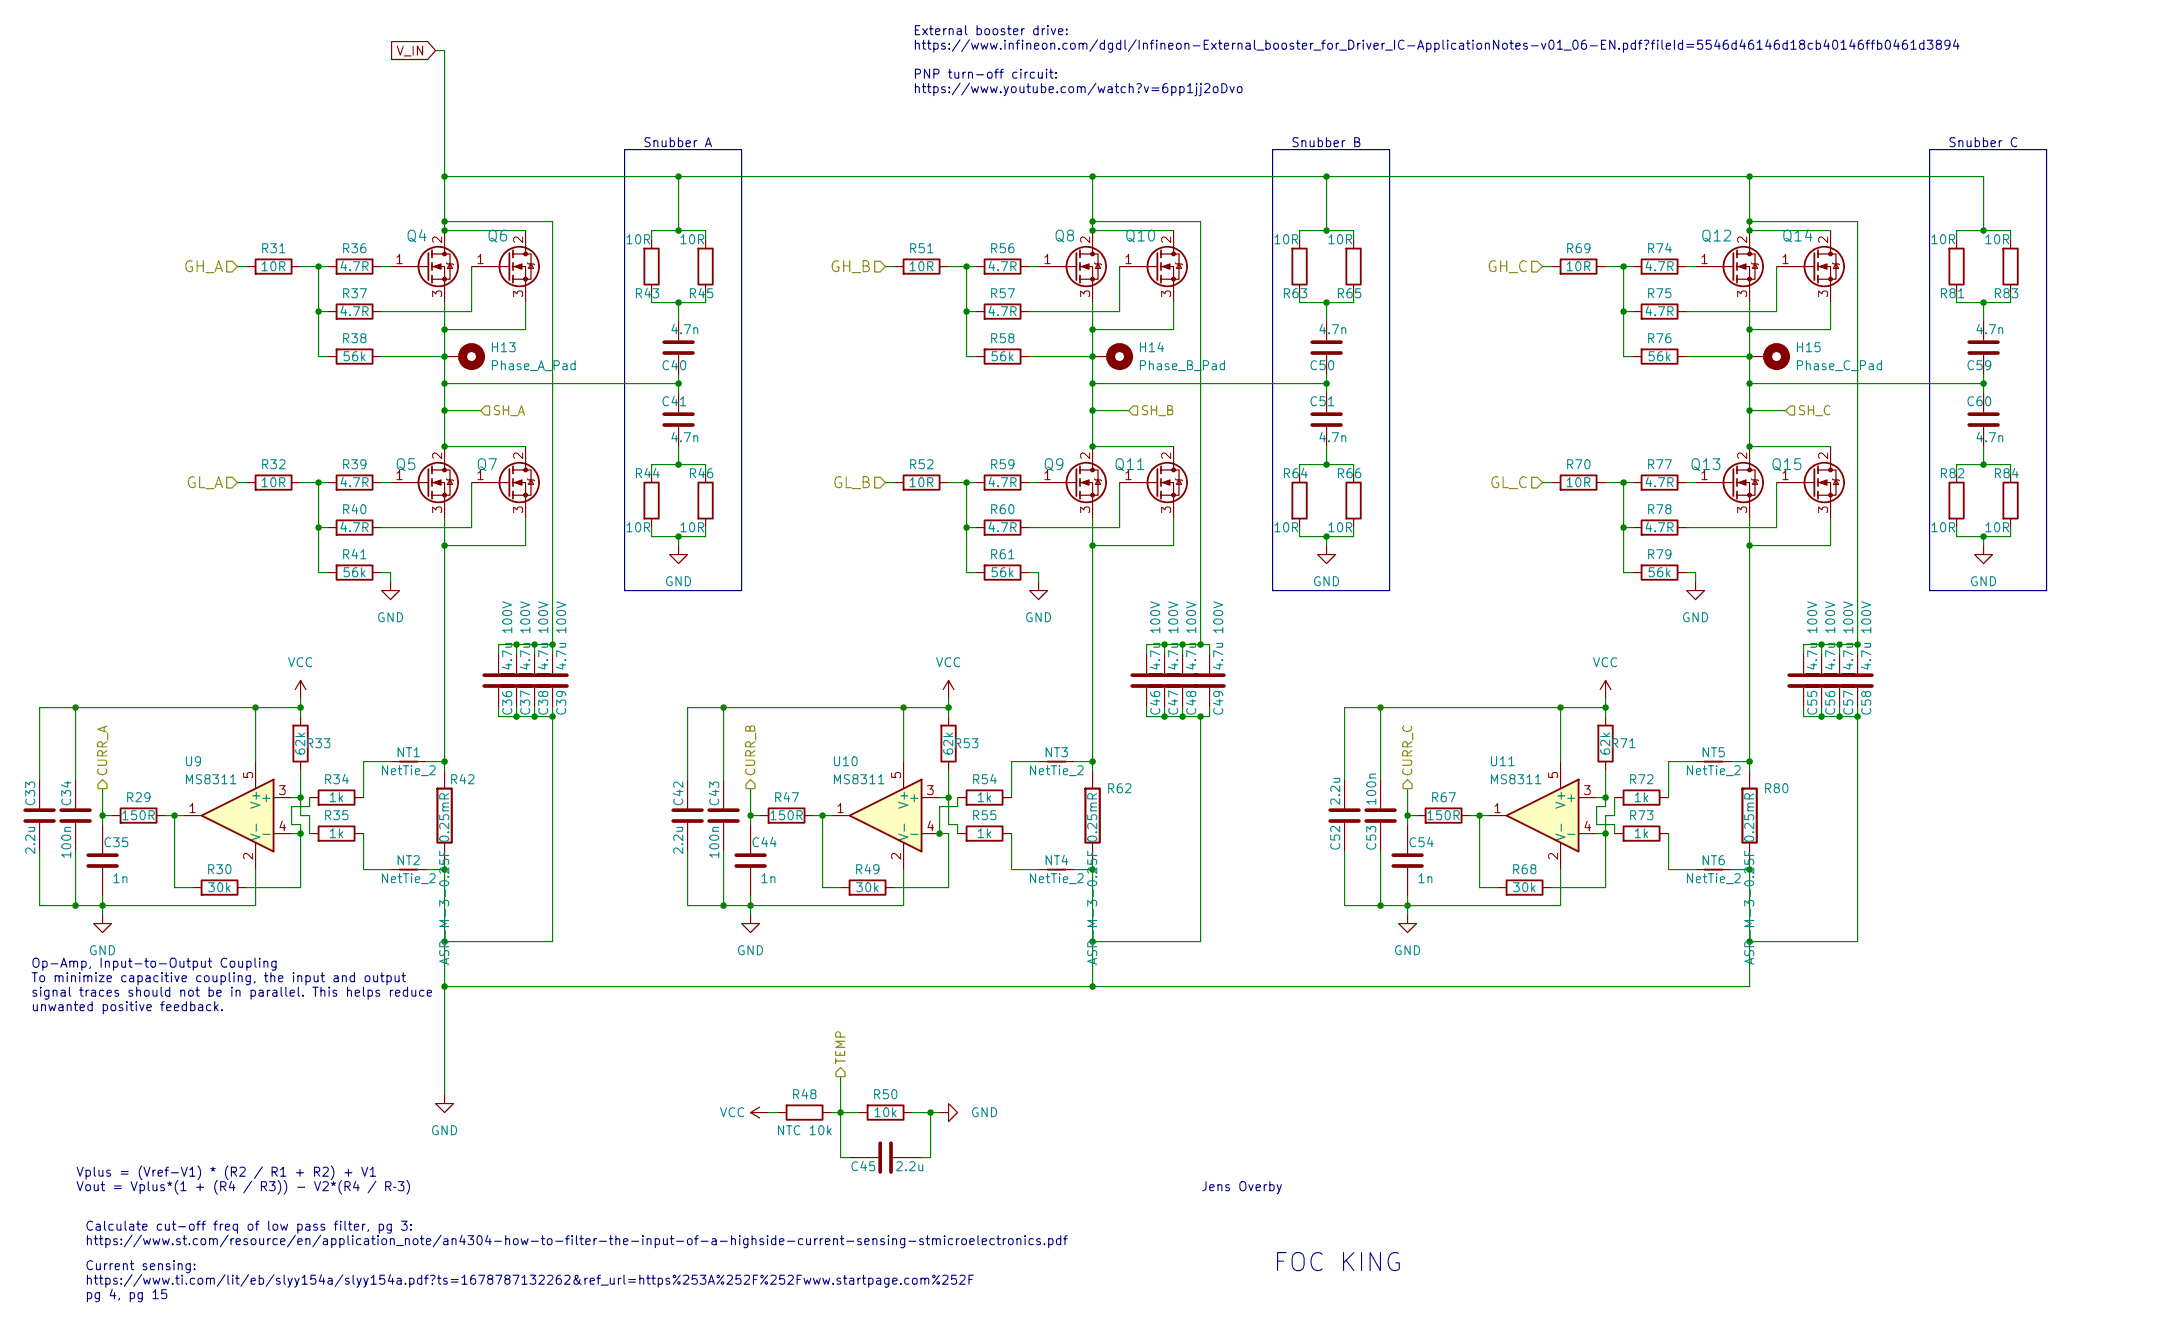
[picture p6: schematic power.kicad_sch]

Parts:
C33, C42, C45, C52: 2.2u; C_0603_1608Metric; LCSC C23630
C34, C43, C53: 100n; C_0603_1608Metric; LCSC C14663
C35, C44, C54: 1n; C_0603_1608Metric; LCSC C1588
C36, C37, C38, C39, C46, C47, C48, C49, C55, C56, C57, C58: 4.7u 100V; C_1210_3225Metric; LCSC C381466
C40, C41, C50, C51, C59, C60: 4.7n; C_0603_1608Metric; LCSC C382251
H13: Phase_A_Pad; MountingHole_3.5mm_Pad_TopOnly_custom
H14: Phase_B_Pad; MountingHole_3.5mm_Pad_TopOnly_custom
H15: Phase_C_Pad; MountingHole_3.5mm_Pad_TopOnly_custom
NT1, NT2, NT3, NT4, NT5, NT6: NetTie_2; NetTie-2_SMD_Pad0.5mm
Q4, Q5, Q6, Q7, Q8, Q9, Q10, Q11, Q12, Q13, Q14, Q15: CRST030N10N; TO-220-3_Vertical_bend; LCSC C841369
R29, R47, R67: 150R; R_0603_1608Metric; LCSC C22808
R30, R49, R68: 30k; R_0603_1608Metric; LCSC C22984
R31, R32, R43, R44, R45, R46, R51, R52, R63, R64, R65, R66, R69, R70, R81, R82, R83, R84: 10R; R_0603_1608Metric; LCSC C22859
R33, R53, R71: 62k; R_0603_1608Metric; LCSC C23221
R34, R35, R54, R55, R72, R73: 1k; R_0603_1608Metric; LCSC C21190
R36, R37, R39, R40, R56, R57, R59, R60, R74, R75, R77, R78: 4.7R; R_0603_1608Metric; LCSC C23164
R38, R41, R58, R61, R76, R79: 56k; R_0603_1608Metric; LCSC C23206
R42, R62, R80: ASR-M-3-0.25F 0.25mR; R_2512_6332Metric; LCSC C495759
R48: NTC 10k; R_0603_1608Metric; LCSC C13564
R50: 10k; R_0603_1608Metric; LCSC C25804
U9: MS8311; TSOT-23-5; LCSC C1509000
U10, U11: MS8311; TSOT-23-5

Connections:
CURR_A: C35.2, R29.2
CURR_B: C44.2, R47.2
CURR_C: C54.2, R67.2
GH_A: R31.2
GH_B: R51.2
GH_C: R69.2
GL_A: R32.2
GL_B: R52.2
GL_C: R70.2
GND: C33.1, C34.1, C35.1, C36.2, C37.2, C38.2, C39.2, C42.1, C43.1, C44.1, C45.1, C46.2, C47.2, C48.2, C49.2, C52.2, C53.2, C54.1, C55.2, C56.2, C57.2, C58.2, NT2.2, NT4.2, NT6.2, R41.1, R42.2, R44.2, R46.2, R50.1, R61.1, R62.2, R64.2, R66.2, R79.1, R80.2, R82.2, R84.2, U9.2 (V-), U10.2 (V-), U11.2 (V-)
unnamed: C40.2, R43.1, R45.1
unnamed: C41.2, R44.1, R46.1
unnamed: C50.2, R63.1, R65.1
unnamed: C51.2, R64.1, R66.1
unnamed: C59.2, R81.1, R83.1
unnamed: C60.2, R82.1, R84.1
unnamed: NT1.1, R34.1
unnamed: NT1.2, Q5.3 (S), Q7.3 (S), R42.1
unnamed: NT2.1, R35.1
unnamed: NT3.1, R54.1
unnamed: NT3.2, Q9.3 (S), Q11.3 (S), R62.1
unnamed: NT4.1, R55.1
unnamed: NT5.1, R72.1
unnamed: NT5.2, Q13.3 (S), Q15.3 (S), R80.1
unnamed: NT6.1, R73.1
unnamed: Q4.1 (G), R36.1
unnamed: Q5.1 (G), R39.1
unnamed: Q6.1 (G), R37.1
unnamed: Q7.1 (G), R40.1
unnamed: Q8.1 (G), R56.1
unnamed: Q9.1 (G), R59.1
unnamed: Q10.1 (G), R57.1
unnamed: Q11.1 (G), R60.1
unnamed: Q12.1 (G), R74.1
unnamed: Q13.1 (G), R77.1
unnamed: Q14.1 (G), R75.1
unnamed: Q15.1 (G), R78.1
unnamed: R29.1, R30.2, U9.1
unnamed: R30.1, R34.2, U9.4 (-)
unnamed: R31.1, R36.2, R37.2, R38.2
unnamed: R32.1, R39.2, R40.2, R41.2
unnamed: R33.1, R35.2, U9.3 (+)
unnamed: R47.1, R49.2, U10.1
unnamed: R49.1, R54.2, U10.4 (-)
unnamed: R51.1, R56.2, R57.2, R58.2
unnamed: R52.1, R59.2, R60.2, R61.2
unnamed: R53.1, R55.2, U10.3 (+)
unnamed: R67.1, R68.2, U11.1
unnamed: R68.1, R72.2, U11.4 (-)
unnamed: R69.1, R74.2, R75.2, R76.2
unnamed: R70.1, R77.2, R78.2, R79.2
unnamed: R71.1, R73.2, U11.3 (+)
SH_A: C40.1, C41.1, H13.1, Q4.3 (S), Q5.2 (D), Q6.3 (S), Q7.2 (D), R38.1
SH_B: C50.1, C51.1, H14.1, Q8.3 (S), Q9.2 (D), Q10.3 (S), Q11.2 (D), R58.1
SH_C: C59.1, C60.1, H15.1, Q12.3 (S), Q13.2 (D), Q14.3 (S), Q15.2 (D), R76.1
TEMP: C45.2, R48.1, R50.2
VCC: C33.2, C34.2, C42.2, C43.2, C52.1, C53.1, R33.2, R48.2, R53.2, R71.2, U9.5 (V+), U10.5 (V+), U11.5 (V+)
V_IN: C36.1, C37.1, C38.1, C39.1, C46.1, C47.1, C48.1, C49.1, C55.1, C56.1, C57.1, C58.1, Q4.2 (D), Q6.2 (D), Q8.2 (D), Q10.2 (D), Q12.2 (D), Q14.2 (D), R43.2, R45.2, R63.2, R65.2, R81.2, R83.2

Notes on the sheet:
Calculate cut-off freq of low pass filter, pg 3: https://www.st.com/resource/en/application_note/an4304-how-to-filter-the-input-of-a-highside-current-sensing-stmicroelectronics.pdf
Snubber C
FOC KING
Op-Amp, Input-to-Output Coupling To minimize capacitive coupling, the input and output signal traces should not be in parallel. This helps reduce unwanted positive feedback.
Jens Overby
Snubber B
External booster drive: https://www.infineon.com/dgdl/Infineon-External_booster_for_Driver_IC-ApplicationNotes-v01_06-EN.pdf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 PNP turn-off circuit: https://www.youtube.com/watch?v=6pp1jj2oDvo
Snubber A
Vplus = (Vref-V1) * (R2 / R1 + R2) + V1 Vout = Vplus*(1 + (R4 / R3)) - V2*(R4 / R­3)
Current sensing: https://www.ti.com/lit/eb/slyy154a/slyy154a.pdf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 pg 4, pg 15
