k3oni/FOC-75300/(notices)

Notices in the files:
hwconf/KING/hw_FOC_KING_core.h:
The VESC firmware is free software: you can redistribute it and/or modify
it under the terms of the GNU General Public License as published by
the Free Software Foundation, either version 3 of the License, or
(at your option) any later version.
